tpikri/bluedi-pedal-controller/assets/img/stomp_switches_display.jpg

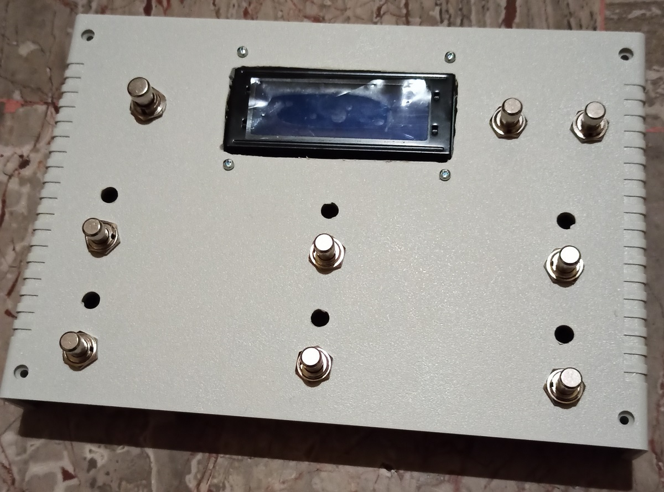
assets/img/stomp_switches_display.jpg
